movement-recognition/pouch-ucboard/_hardware/pcb/dimensions.pdf

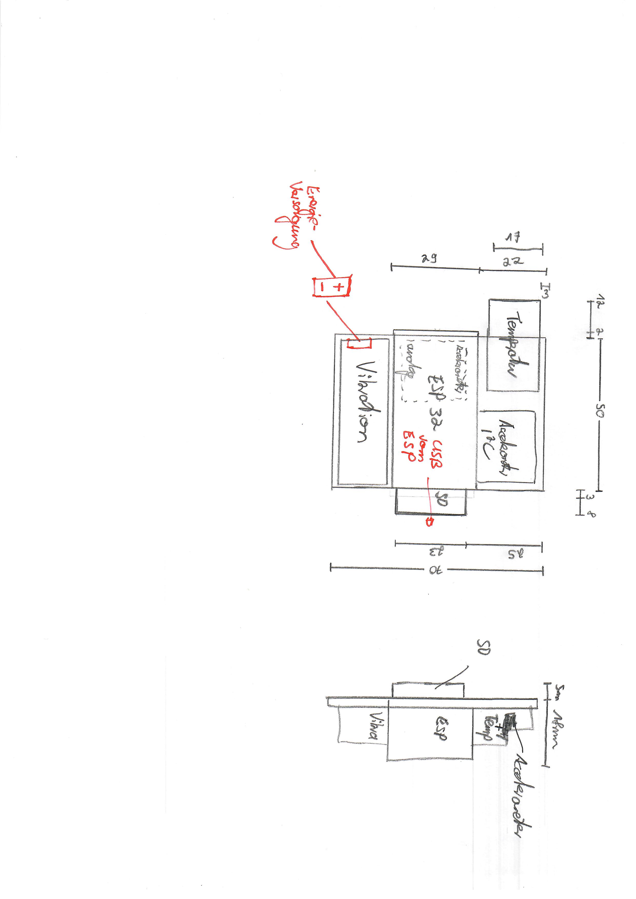
[picture p2: page 1]
