movement-recognition/pouch-ucboard/_hardware/adc-pins-esp32-f.jpg

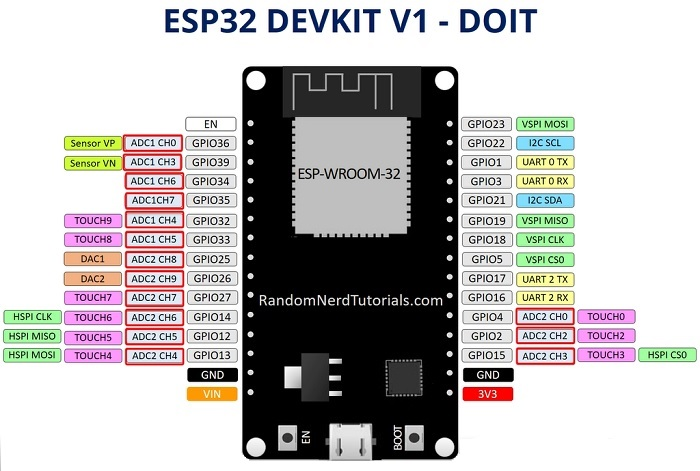
_hardware/adc-pins-esp32-f.jpg
