movement-recognition/pouch-ucboard/_hardware/ADXL345_breakout.jpg

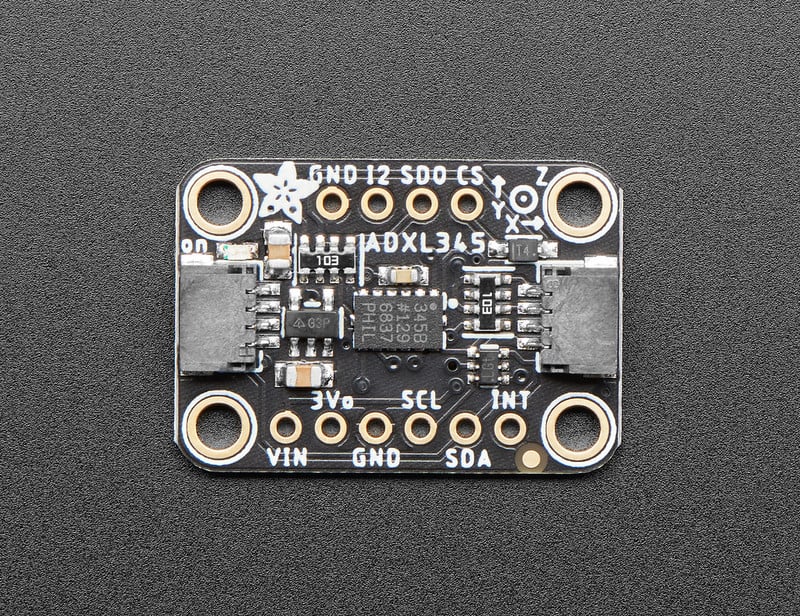
_hardware/ADXL345_breakout.jpg
