movement-recognition/pouch-ucboard/_hardware/ADXL377.jpg

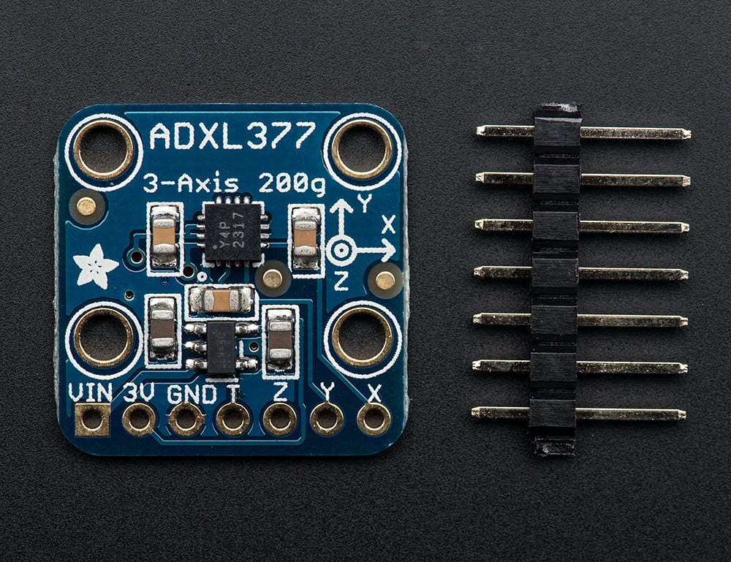
_hardware/ADXL377.jpg
