movement-recognition/pouch-ucboard/_hardware/esp32.jpg

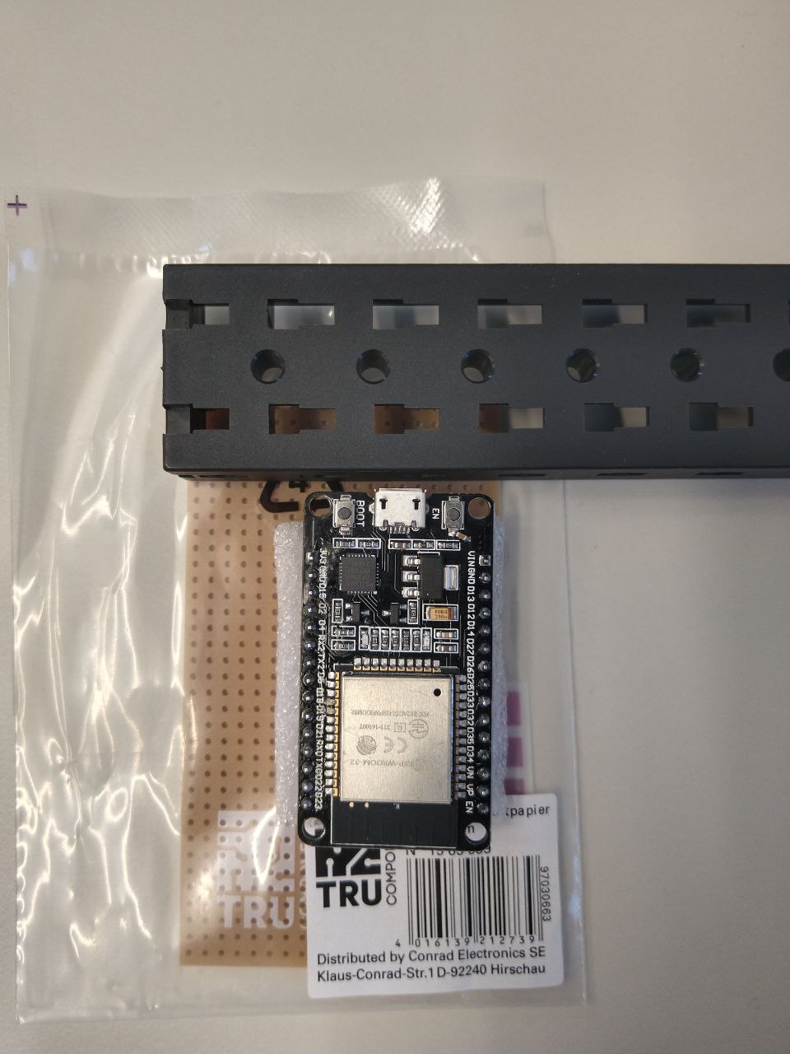
_hardware/esp32.jpg
