movement-recognition/pouch-ucboard/_hardware/pcb/side_view.jpg

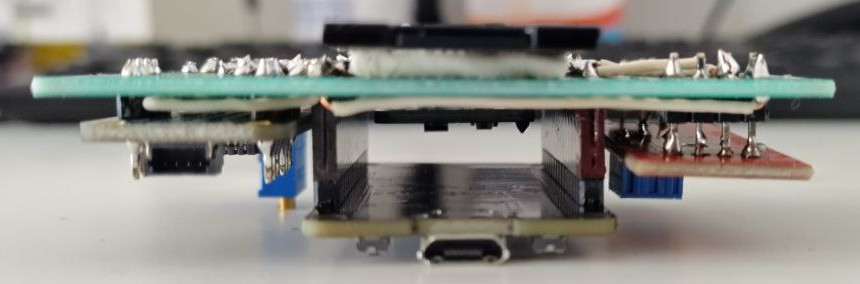
_hardware/pcb/side_view.jpg
