movement-recognition/pouch-ucboard/docs/grafana-configure0.png

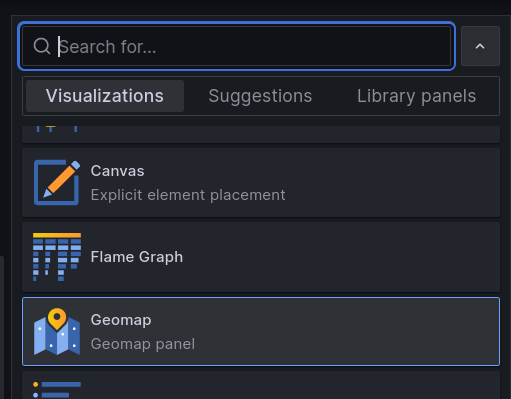
docs/grafana-configure0.png
