movement-recognition/pouch-ucboard/docs/grafana-configure1.png

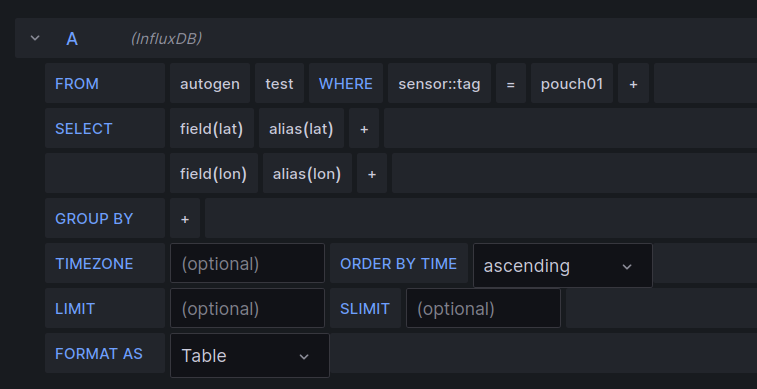
docs/grafana-configure1.png
