movement-recognition/pouch-ucboard/docs/grafana-configure2.png

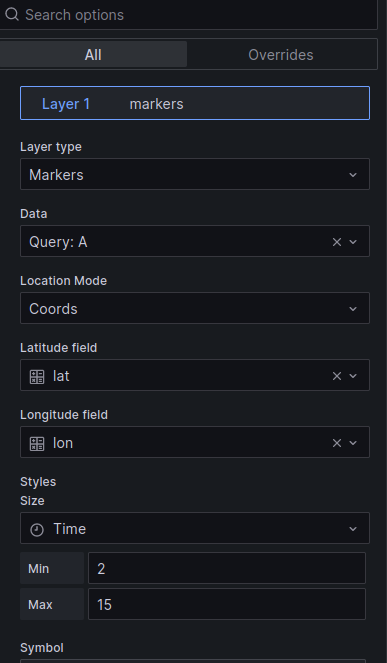
docs/grafana-configure2.png
