movement-recognition/pouch-ucboard/docs/sensorbox_anal_radial_alltime.png

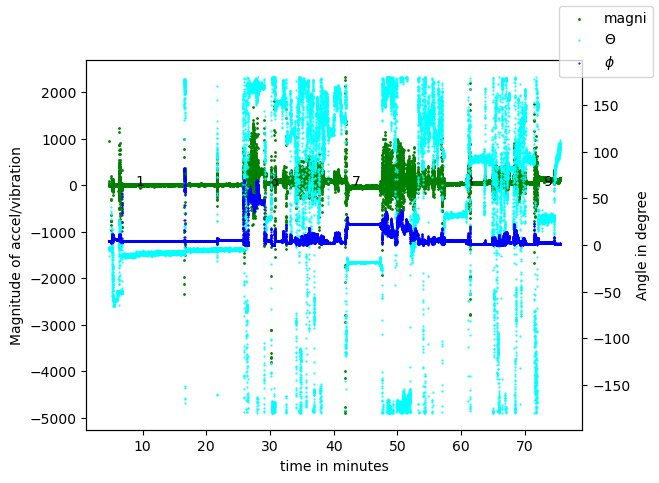
docs/sensorbox_anal_radial_alltime.png
