movement-recognition/pouch-ucboard/docs/sensorbox_anal_radial_Gabelstapler.png

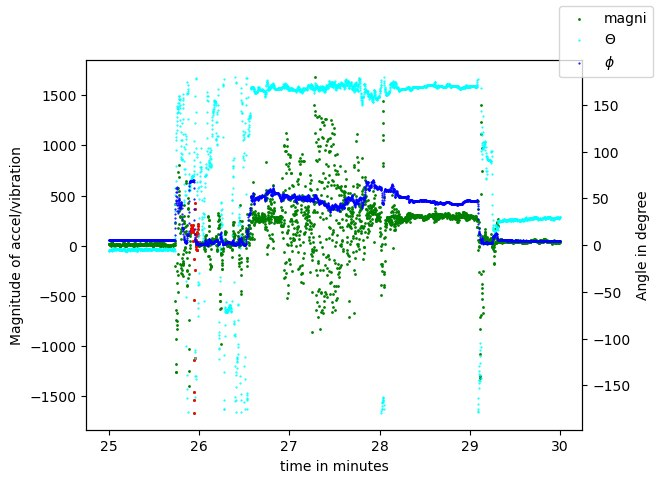
docs/sensorbox_anal_radial_Gabelstapler.png
