movement-recognition/pouch-ucboard/docs/sensorbox_anal_radial_LKW.png

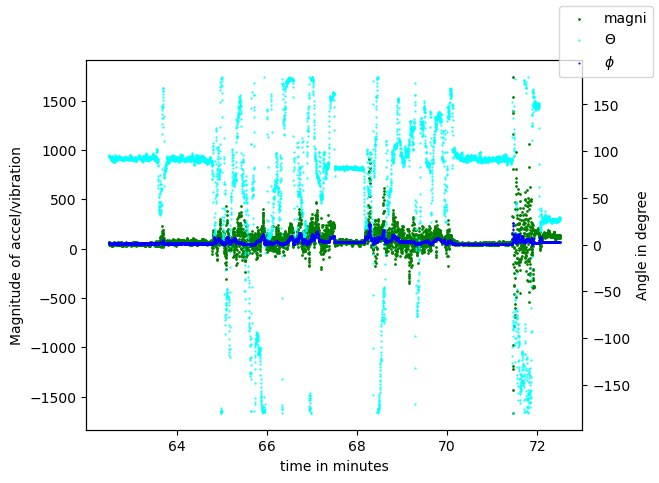
docs/sensorbox_anal_radial_LKW.png
