movement-recognition/pouch-ucboard/docs/sensorbox_anal_radial_Sprinter.png

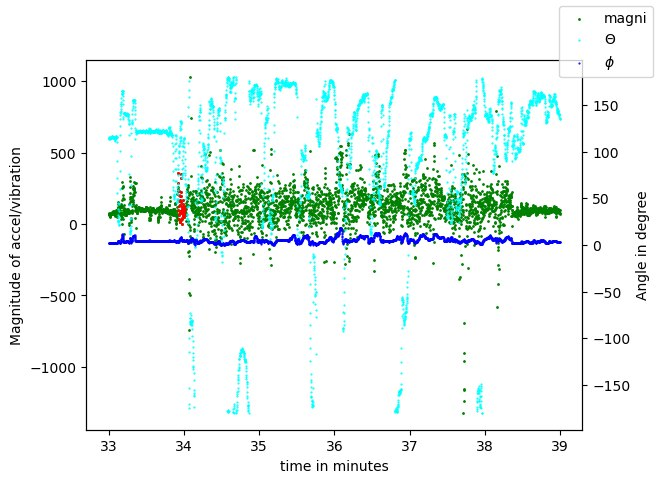
docs/sensorbox_anal_radial_Sprinter.png
