movement-recognition/pouch-ucboard/docs/sensorbox_anal_raw.png

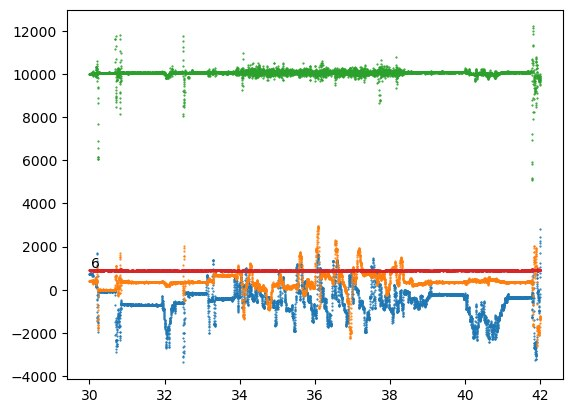
docs/sensorbox_anal_raw.png
