movement-recognition/pouch-ucboard/docs/sensorbox_anal_raw_alltime.png

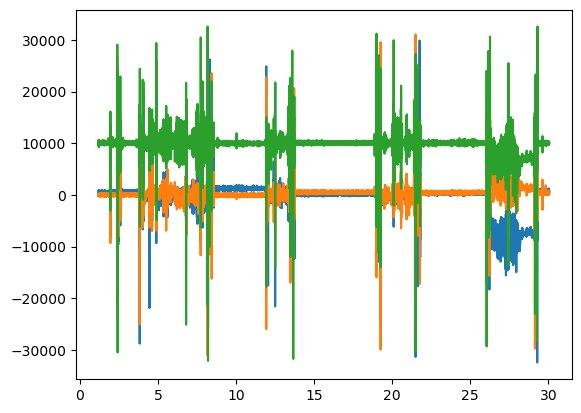
docs/sensorbox_anal_raw_alltime.png
