movement-recognition/pouch-ucboard/docs/sensorbox_freefall.png

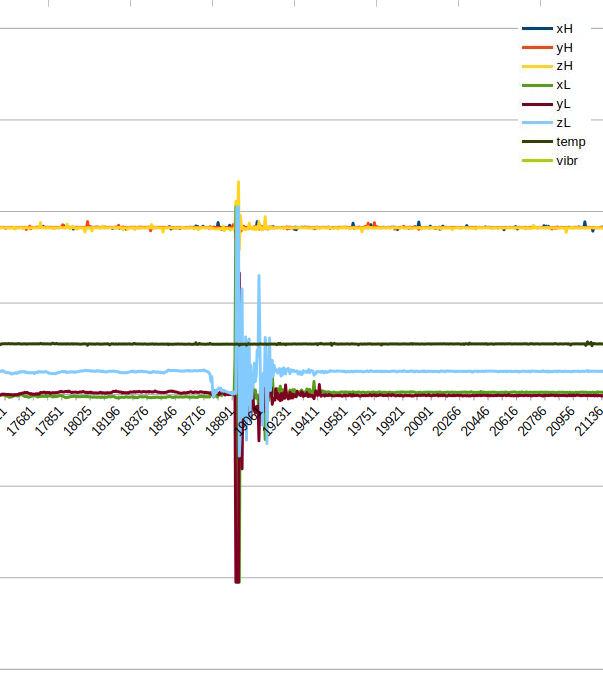
docs/sensorbox_freefall.png
