movement-recognition/pouch-ucboard/docs/sensorbox_up_down.png

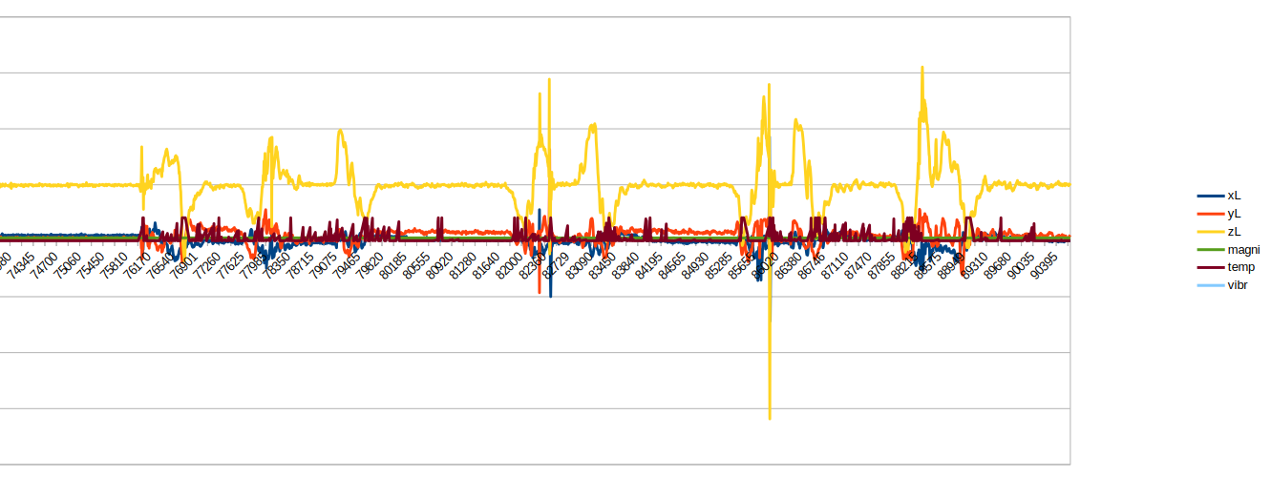
docs/sensorbox_up_down.png
