movement-recognition/pouch-ucboard/schematic/schematic.pdf

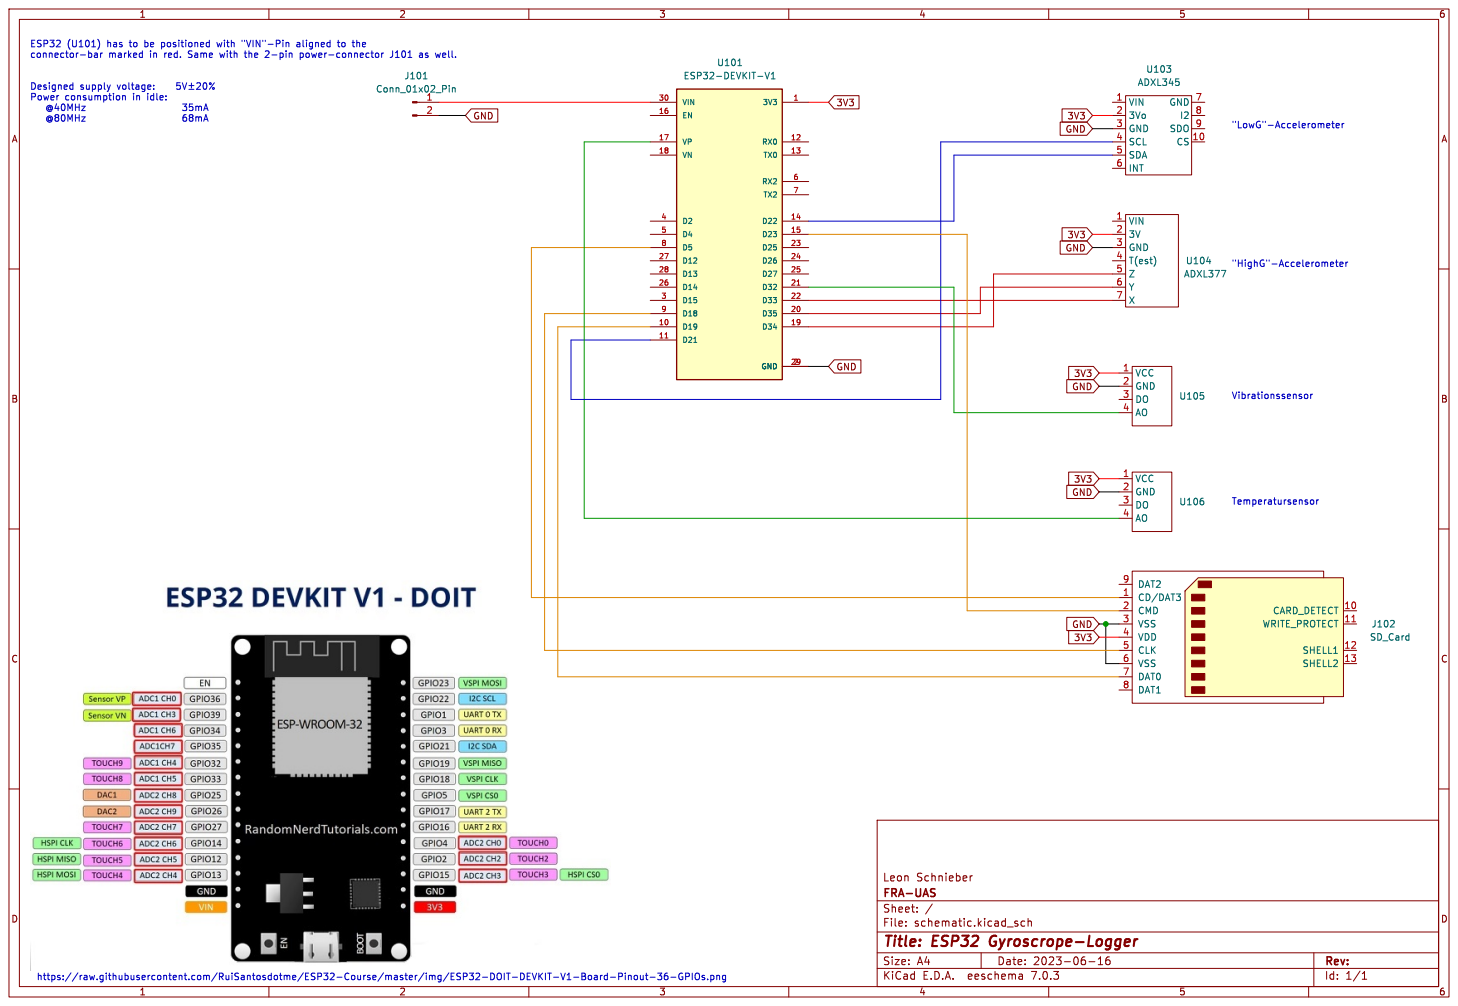
[picture p19: page 1]

"HighG"-Accelerometer "LowG"-Accelerometer

Leon Schnieber
Id: 1/1 Title: ESP32 Gyroscrope-Logger File: schematic.kicad_sch Sheet: / FRA-UAS

https://raw.githubusercontent.com/RuiSantosdotme/ESP32-Course/master/img/ESP32-DOIT-DEVKIT-V1-Board-Pinout-36-GPIOs.png
