movement-recognition/pouch-ucboard/schematic/schematic.kicad_sch

## KiCad design schematic/schematic.kicad_sch (2023-06-18, an earlier design)

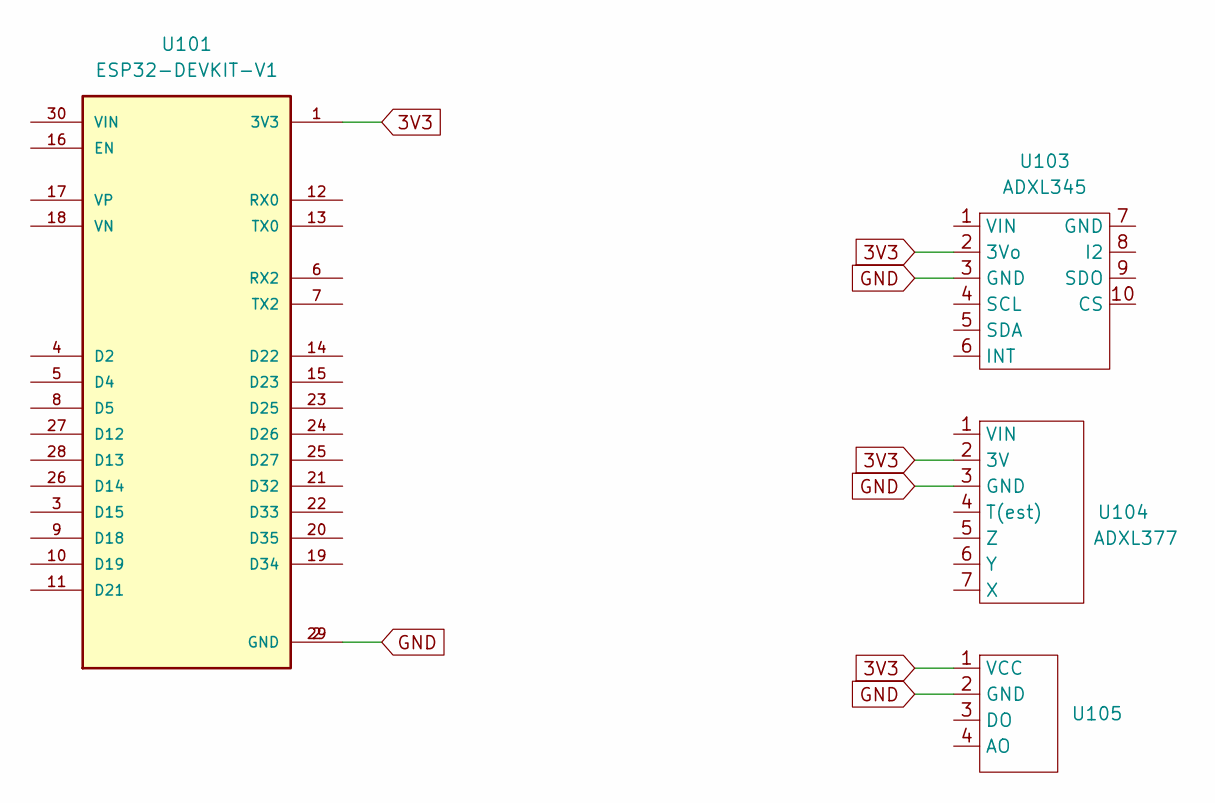
[picture p20: schematic schematic.kicad_sch]

Parts:
U101: ESP32-DEVKIT-V1; MODULE_ESP32_DEVKIT_V1; PARTREV N/A
U102, U105: (no value)
U103: ADXL345
U104: ADXL377

Connections:
3V3: U101.1 (3V3), U103.2 (3Vo), U104.2 (3V), U105.1 (VCC)
GND: U101.2 (GND), U101.29 (GND), U103.3 (GND), U104.3 (GND), U105.2 (GND)
