movement-recognition/pouch-ucboard/src/main/sd_card.cpp

#include <stdint.h>
#include <Arduino.h>
#include <FS.h>
#include <SD.h>
#include <SPI.h>


#include "sd_card.h"


void SD_Card::setup() {
    filename[0] = '/';
    filename[1] = 'd';
    filename[2] = 'a';
    filename[3] = 't';
    filename[4] = '_';
    for(byte i = 5; i < 9; i++) {
        filename[i] = 97 + random(26);
    }
    filename[9] = '.';
    filename[10] = 'c';
    filename[11] = 's';
    filename[12] = 'v';

    pinMode(23, INPUT_PULLUP);
    SPI.begin(18, 19, 23);


    if(!SD.begin(HW_SDCARD_CS_PIN, SPI, 4000000)){
        Serial.println("Card Mount Failed");
        return;
    }
    uint8_t cardType = SD.cardType();

    if(cardType == CARD_NONE){
        Serial.println("No SD card attached");
        return;
    }

    Serial.print("SD Card Type: ");
    if(cardType == CARD_MMC){
        Serial.println("MMC");
    } else if(cardType == CARD_SD){
        Serial.println("SDSC");
    } else if(cardType == CARD_SDHC){
        Serial.println("SDHC");
    } else {
        Serial.println("UNKNOWN");
    }

    uint64_t cardSize = SD.cardSize() / (1024 * 1024);
    Serial.printf("SD Card Size: %lluMB\n", cardSize);

    dataFile = ((fs::FS)SD).open("/rawData.csv", FILE_APPEND);
};

void SD_Card::write(char* data) {
    if(!dataFile) {
        dataFile = ((fs::FS)SD).open("/rawData.csv", FILE_APPEND);
    }

    if(! dataFile.print(data)) {
        Serial.println("writing failed.");
    }
}


// copied form example-snippet in the Arduino-ESP32-Library
void SD_Card::listDir(fs::FS &fs, const char * dirname, uint8_t levels){
    Serial.printf("Listing directory: %s\n", dirname);

    File root = fs.open(dirname);
    if(!root){
        Serial.println("Failed to open directory");
        return;
    }
    if(!root.isDirectory()){
        Serial.println("Not a directory");
        return;
    }

    File file = root.openNextFile();
    while(file){
        if(file.isDirectory()){
            Serial.print("  DIR : ");
            Serial.println(file.name());
            if(levels){
                listDir(fs, file.name(), levels -1);
            }
        } else {
            Serial.print("  FILE: ");
            Serial.print(file.name());
            Serial.print("  SIZE: ");
            Serial.println(file.size());
        }
        file = root.openNextFile();
    }
}

void SD_Card::writeFile(fs::FS &fs, const char * path, const char * message){
    // Serial.printf("Writing file: %s\n", path);

    File file = fs.open(path, FILE_WRITE);
    if(!file){
        Serial.println("Failed to open file for writing");
        return;
    }
    if(file.print(message)){
        // Serial.println("File written");
    } else {
        Serial.println("Write failed");
    }
    file.close();
}

void SD_Card::appendFile(fs::FS &fs, const char * path, const char * message){
    // Serial.printf("Appending to file: %s\n", path);

    File file = fs.open(path, FILE_APPEND);
    if(!file){
        Serial.println("Failed to open file for appending");
        return;
    }
    if(file.print(message)){
        // Serial.println("Message appended");
    } else {
        Serial.println("Append failed");
    }
    file.close();
}

void SD_Card::readFile(fs::FS &fs, const char * path){

    File file = fs.open(path);
    if(!file){
        Serial.println("Failed to open file for reading");
        return;
    }

    while(file.available()){
        Serial.write(file.read());
    }
    file.close();
}
