movement-recognition/pouch-ucboard/(commit log)

2023-06-17 general rework
    [schematic.kicad_sch]
2023-06-18 delta-inner-outer analysis deployed
    [rawData.csv, schematic.kicad_sch]
2023-06-20 added schematic as pdf
2023-06-20 added data-flow
2023-07-02 updated details in data-flow diagram
2023-07-05 add old test-data from 2023-06-26
    [2023-06-26_t1-6_anal.csv]
2023-07-14 added data from hamburg
    [2023-07-12_rawData.csv]
2024-03-15 added gyro sensor to codebase
